RBChavez/DocInaBox/Source/Arduino_Sketch/Readme.txt

-libraries folder contain the libraries that the project used
-mDocInABox_ contain the code of the project.

Note: Include libraries in the project before load into the Arduino UNO board.
