RBChavez/DocInaBox/AcademicDocuments/ProjectDiagram.png

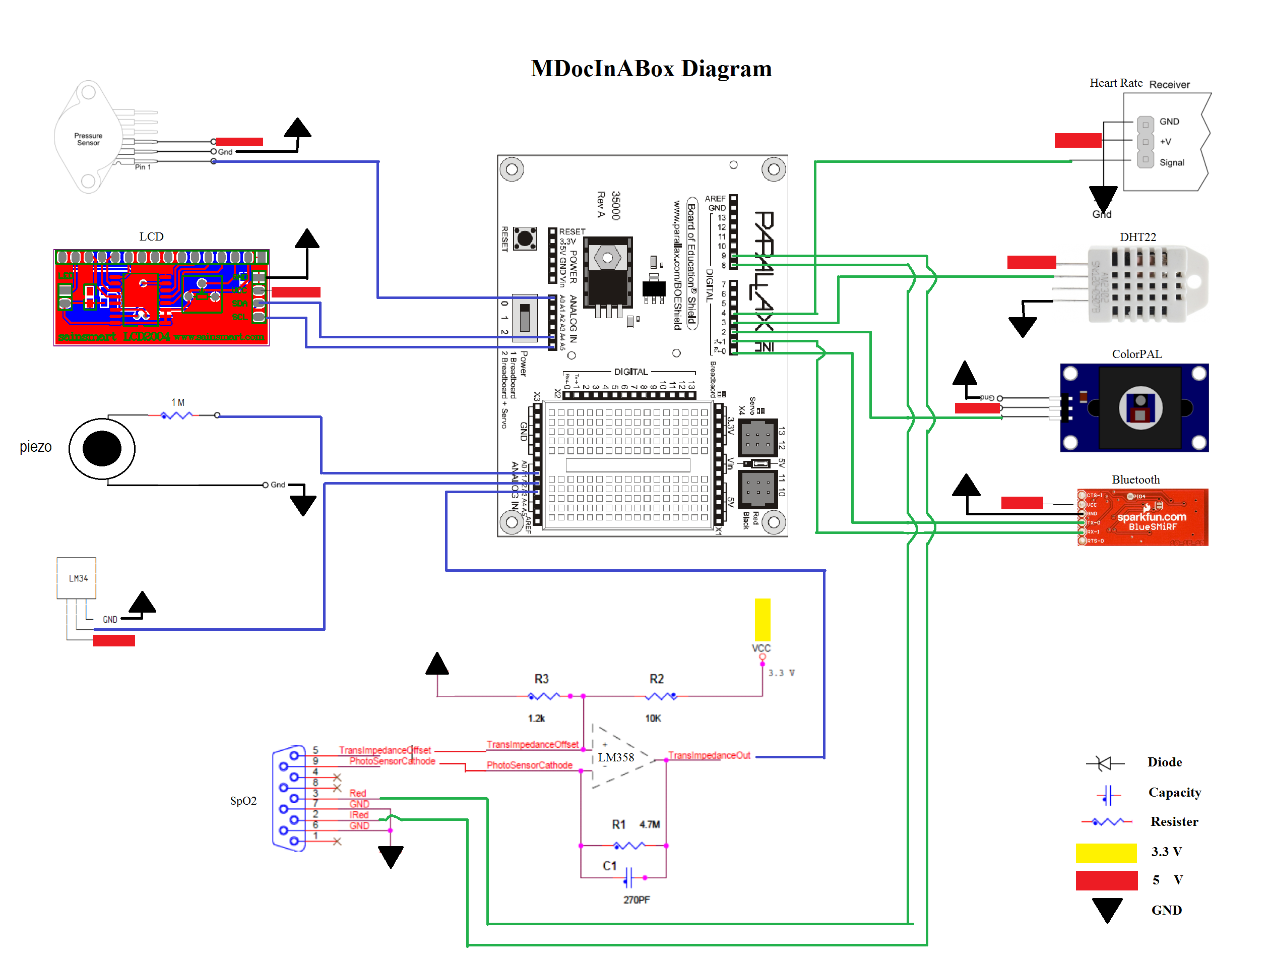
AcademicDocuments/ProjectDiagram.png
