RBChavez/DocInaBox/AcademicDocuments/Screenshot1.png

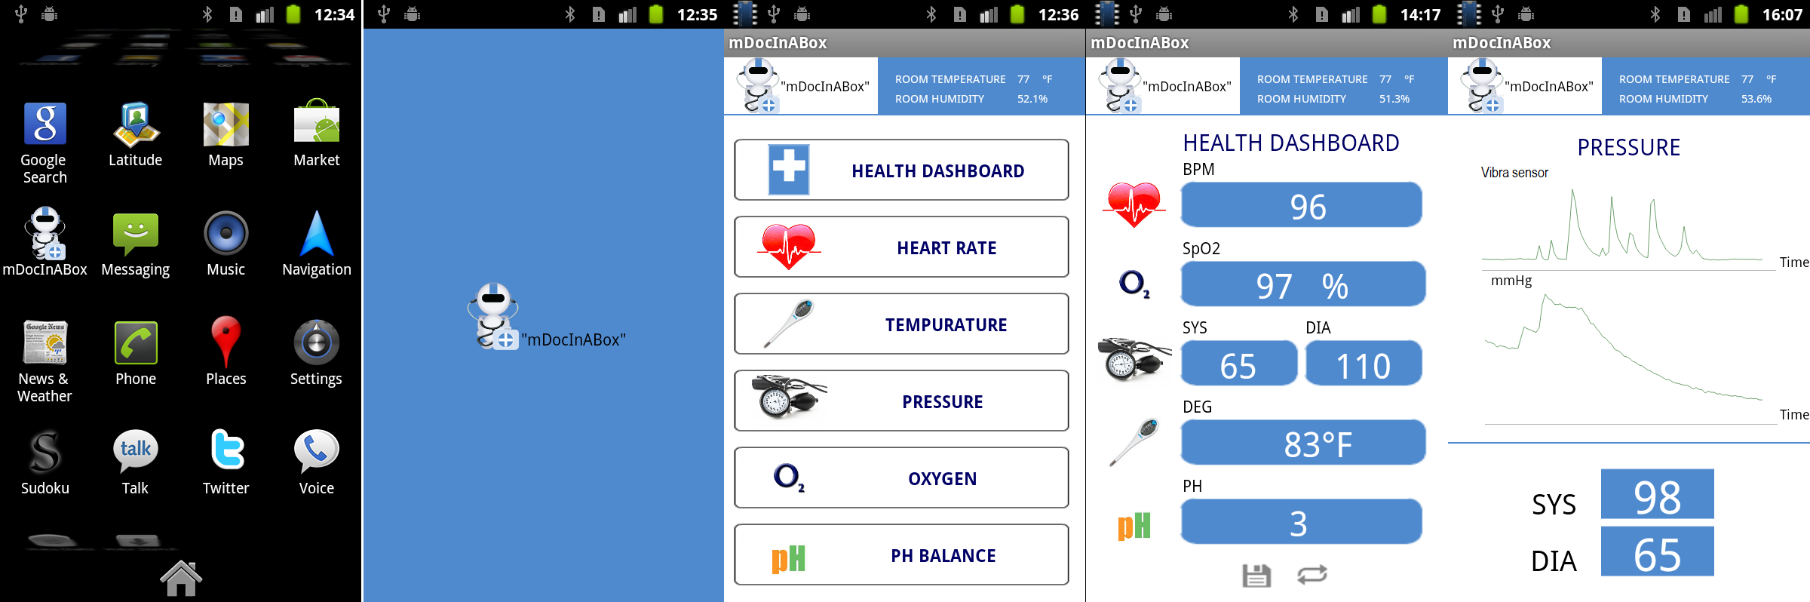
AcademicDocuments/Screenshot1.png
