RBChavez/DocInaBox/Source/Android_App/mDocInABox/ic_launcher-web.png

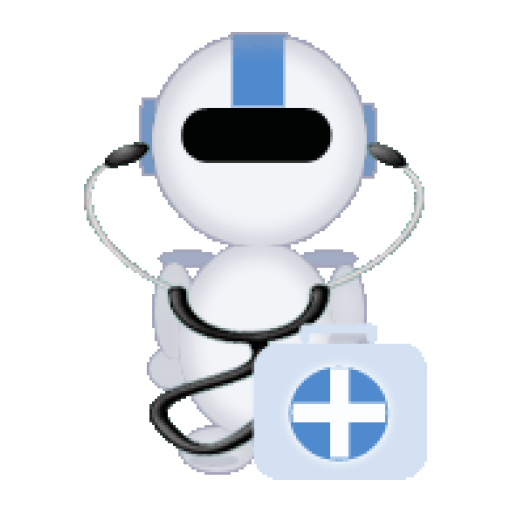
Source/Android_App/mDocInABox/ic_launcher-web.png
